BackupGGCode/hovercraft/README.md

#Hovercraft
Part of the Software for Embedded Systems course.  This sourcecode is used to create an autonomous hovercraft.
