BackupGGCode/hovercraft/projectWriteup/projectHTML/HovercraftDesign.html

# Design

The following figures show the top, side, front and rear views for the vehicle:

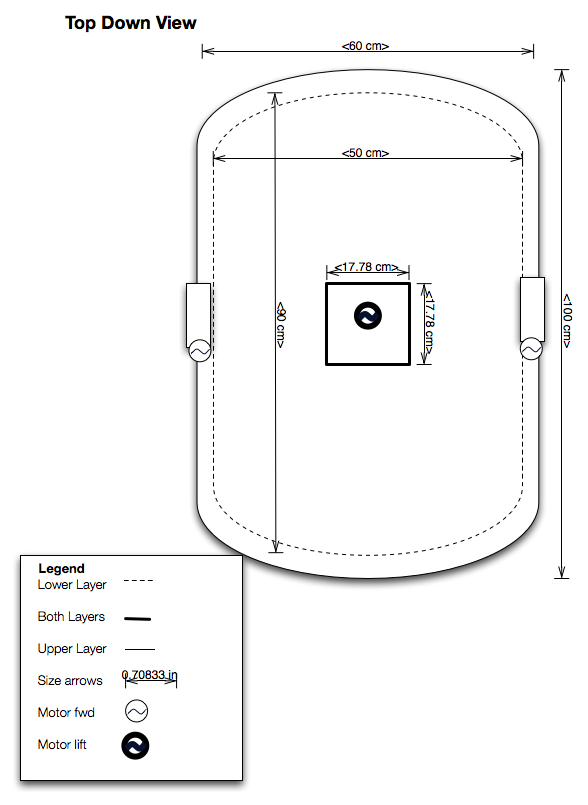
[picture p9: projectWriteup/ProjectGraphics/TopDown.png]


The first design consisted of a rounded front, straight sides and a straight back. However, since the front and back were not symmetric, we concluded that the rear of the craft should be rounded to match the front. This symmetric design better distributes the underlying air cushion to all parts of the vehicle.

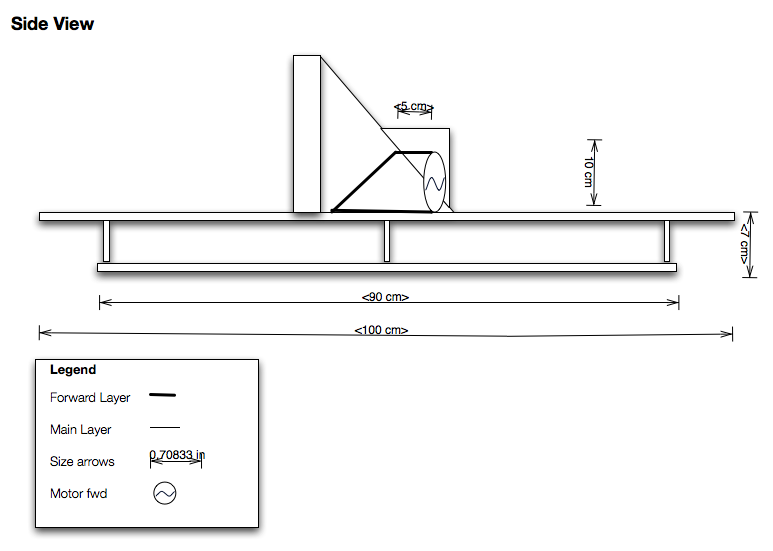
[picture p10: projectWriteup/ProjectGraphics/sideview.png]


The plenum chamber receives air from a single propeller mounted in the middle of the chasis. The middle propeller is housed by a triangular container. Initially the container was completely open on the side where the propeller draws air from. We realized that too much air was escaping from this hole and a cover with a circular cut-out was fitted over the opening. The cut-out better fit the diameter of the fan, resulting in minimal air escaping from the opening.



The electronic components are mounted at the rear of the hovercraft. This facilitates making connections from the breadboard to the nearby DC Motors, servo motor, and sonars. The combined mass of all the components added a significant force to the rear of the chasis. To counter this, we placed counter weights on the front of the body.



# Constraints

## Payload Weight

In order for the hovercraft to stay afloat, the internal air pressure must counter external forces placed on the surface of the vehicle by both gravity and the mass of the components. The following table describes the components and their masses:

Component | Quantity | Mass(grams)
Battery | 2 | 50
Breadboard | 1 | 45
Microcontroller | 1 | 15
Radio | 1 | 9
Sonar | 3 | 5
DC Motor (large) | 1 | 83
Servo Motor | 1 | 4
H-bridge | 1 | 6
DC Motor (small) | 2 | 25
Total | -- | 329

## Rigidity

The hovercraft body is made from two thin sheets of styrofoam separated by 12 styrofoam spacers 1'' thick. This has proven to be a very strong design, easily capable of supporting the payload of the electronics. In fact, we distributed additional weight evenly across the body and found that the hovercraft could support at least 1 kg.





An inflatable skirt made of mylar surrounds the body. Mylar is a polyester film often used in flexible packaging for food, as an insulating material, and for solar reflection. Once inflated, the skirt serves two purposes. First, because it expands to over two inches, it provides additional surface area, reducing the overall pressure at any given point on the body. Second, the skirt acts as a flexible and damage resistant bumper, protecting the body from nearby objects during testing. We used two different mediums to connect the skirt to the styrofoam body. First we adhered the mylar to the styrofoam using hot glue, we then went around the perimeter with a hot iron to melt the mylar, the glue and the styrofoam together.



After the styrofoam chasis was built, we then procdeded to construct the skirt. The first attempt at constructing the mylar skirt was not successful. Lack of foresight resulted in a skirt that was too baggy in some areas, while exposing too many holes in others. The first time that we attached the mylar, when we were connecting the corners, we used clear packing tape, and simply folded the corners together. The second attempt was much more calculated and pragmatic. When connecting the corners of the second skirt, we methodically folded the edges in, then removed the square that was not attached (see Mylar-Cutout diagram). After this we made the connection using the hot iron to glue the seam together. The resulting skirt was much more evenly distributed and provided reasonably uniform inflation around the entire body. That said, the hovercraft still managed to move about when it was supposed to be idle. We addressed this issue by placing weights on the body to counteract the uneven escape of air on one side.

## Lift

The decision to use a single, vertically mounted propeller to feed air into the plenum chamber was in direct response to the problem of rotational torque plaguing horizontally mounted propellers. In a horizontal design, the rotation of the blades applies an overall torque on the hovercraft causing it to spin. Dealing with this force is a burden. One approach is to install a second horizontal propeller which spins in the opposite direction. The opposite spin of the two motors cancels any directional torque felt by the craft. We chose to avoid this problem entirely by mounting a single motor vertically in the middle of the body. A container built over the propeller captures the incoming air and forces into the plenum chamber.





To avoid ground effect, we applied full power to the lift propeller. Next, we methodically added weight to the body such that the hovercraft moved freely along the ground, but was not vastly overpowered by the fan. Keeping the vehicle as close as possible to the ground allows for the most control over the hovercraft's direction.

## Thrust and Control

The following two figures show the first design we had chosen to provide the vehicle with thrust. The two differential motors were mounted at the rear, and were spaced fairly close together.





We decided to change this design. By placing the motors as far apart as possible, maximum torque could be achieved. The analogy is as follows. Consider the act of opening a door. It is much easier to open a door if you push on the edge furthest from the hinges, because you can generate much more torque. The same goes for our hovercraft. Ideally the centre of rotation (the hinge) is in the centre of the hovercraft. By placing the motors as far away from this centre, we will create the most rotational torque and the craft will be easily controlled

### Remote Control Code

The following functions are part of the base station software. They are used to send control signals form the joystick to the hovercraft, using radio communication.

	unsigned char X = 0, Y = 0, Z = 0;

	void updateMotor(){	
		packet_t packet;

		sample_joystick(&X,&Y,&Z);

		_delay_ms(250);
		char test[50];	
		updateVertically();

		packet.x = (uint8_t) X;
		packet.y = (uint8_t) Y;
		radio_send(HOV_ADDRESS, (uint8_t*) &packet);	
	}

	void updateVertically(){
		int intY = (int) Y;
		int len = 0;
		char toWrite[50];
		uint8_t newSpeed = 0;

		if(intY > 125){ //To go Backwards
			setMotorDirection(BACKWARD);
			newSpeed = (intY-125)*2;
			setMotorSpeed( newSpeed);
			len = sprintf(toWrite, "Motor Speed Is Backward %d\r\n", intY);
		}else{
			setMotorDirection(FORWARD);
			newSpeed = 256 - intY*2;
			setMotorSpeed(newSpeed);
			len = sprintf(toWrite, "Motor Speed Is Forward %d\r\n", newSpeed);
		}

		_delay_ms(250);	
	}

### Differential Turning Code

To implement differential turning, we began by using the provided motor driver code. We then defined a struct to abstract a motor:

	/**
	 * A motor type.
	 */
	typedef struct
	{
	    /** The port at which the PWM signal is coming out of. */
	    volatile uint8_t *pwmPort;

	    /** The data direction register for PWM. */
	    volatile uint8_t *pwmDDR;

	    /** The PWM pin. */
	    uint8_t pwmPin;

	    /** The port at which the direction of the motor can be controlled. */
	    volatile uint8_t *directionPort;

	    /** The data direction register for the direction pin. */
	    volatile uint8_t *directionDDR;

	    /** The direction pin. */
	    uint8_t directionPin;

	    /** The register that contains the TOP value. */
	    volatile uint8_t *topRegister;
	} motor_t;

We also defined an enumerated type to represent forward and backward direction:

	typedef enum
	{
	    FORWARD, BACKWARD
	} direction_t;

The two motors and the timer for pulse width modulation must first be initialized:

	/**
	 * Initialization method for the motors.
	 *
	 * @param motor The motor to be initialized.
	 */
	void motorInit(motor_t * motor);

	/**
	 * Initializes the Timer/Counter 0 for PWM.
	 */
	void pwmInit();

The following functions are used to control the independent speed and direction of the motors. By allowing the duty of each motor to be set, differential turning can be established.

/**
 * Sets the speed of the motor.
 *
 * @param motor The motor to be affected.
 * @param duty  The new duty cycle.
 */
void setMotorDuty(motor_t *motor, int duty);

/**
 * Sets the motor direction.
 *
 * @param motor     The motor to be affected.
 * @param direction The direction for the motor to spin.
 */
void setMotorDirection(motor_t *motor, direction_t direction);
