BackupGGCode/hovercraft/projectWriteup/ProjectGraphics/DifferentialTurning.graffle/QuickLook/Preview.pdf

# Differential Turning

Differential turning is achieved by placing two propellers at the rear of the hovercraft. By applying different duties to each of the propellers (via PWM), one will spin faster than the other, causing the vehicle to turn.
