BackupGGCode/hovercraft/projectWriteup/ProjectGraphics/VortexRing.graffle/QuickLook/Preview.pdf

# Vortex Ring

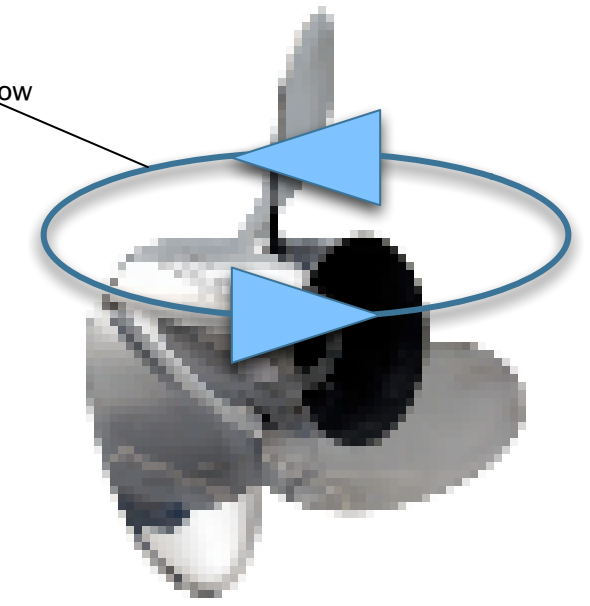
[picture p12: figure]

Airflow begins to loop back through the propeller, severely reducing lift.

Airflow
