BackupGGCode/hovercraft/projectWriteup/FINAL_REPORT/main.tex

%\documentclass[letterpaper]{sig-alternate}
\documentclass{article}
\usepackage[left=1.0in,right=1.0in,nohead,nofoot]{geometry}
\usepackage{multirow} 
\usepackage{rotating}
\usepackage{listings}
\usepackage{color}
\usepackage{capt-of}
\usepackage{caption}
\usepackage{float}
\usepackage{subfig}
\usepackage{pdfsync}
\usepackage[bookmarks=true,pdftex]{hyperref}

\begin{document}
\lstset{captionpos=b,
        breaklines=true,
        frame=single,
        showstringspaces=false,
        basicstyle=\footnotesize,
        numberstyle=\tiny,
        tabsize=2,
        language=C,
        numbers=left,
        stepnumber=2,
        numbersep=5pt,
        commentstyle=\textit}

%\conferenceinfo{}
%\CopyrightYear{}
%\crdata{}

\title{Software for Embedded Systems\\Hovercraft Project\\Final Report}

\author{Darren Minifie \and Marco Yuen \and Kat Gunion \and Anthony Estey}

\date{April 23, 2009}
\maketitle
\begin{abstract}
Hovercraft report abstract here.
\end{abstract}

\tableofcontents
\listoffigures
\listoftables
\newpage

%A category including the fourth, optional field follows...
%\category{D.2.8}{Software Engineering}{Metrics}[complexity measures, performance measures]

%\terms{}

\section{Introduction}
\input{textSources/introduction}
\clearpage
\section{Electronic Components and Their Interface}
\input{textSources/electronicComponents}
\clearpage
\section{Hovercraft Design and Construction}
\input{textSources/hovercraftDesignConstruction}
\clearpage
\section{PID Controller}
\input{textSources/pidController}
\clearpage
\section{Embedded Software for Automation}
\label{embeddedSoftwareAutomation}
\input{textSources/embeddedSoftwareAutomation}
\clearpage
\section{Real Time Operating System (RTOS)}
\input{textSources/rtos}
\clearpage
\section{Physical Parameters: Methodologies and Measurements}
\input{textSources/methodsMeasurements}
\clearpage
%\section{Observations and Evaluations}
%\input{textSources/observationsEvaluations}
%\clearpage
\section{Conclusion}
\input{textSources/conclusion}
\clearpage
%ACKNOWLEDGMENTS are optional
%\section{Acknowledgments}

\bibliographystyle{abbrv}
\bibliography{bibliography}  % sigproc.bib is the name of the Bibliography in this case

\end{document}
