BackupGGCode/hovercraft/projectWriteup/FINAL_REPORT/imageSources/Bottom2.png

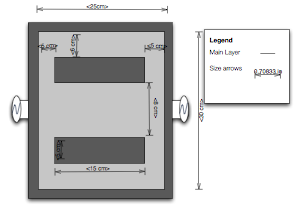
projectWriteup/FINAL_REPORT/imageSources/Bottom2.png
