BackupGGCode/hovercraft/projectWriteup/FINAL_REPORT/imageSources/BottomFinal.png

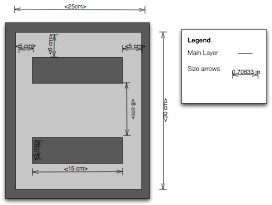
projectWriteup/FINAL_REPORT/imageSources/BottomFinal.png
