BackupGGCode/hovercraft/projectWriteup/FINAL_REPORT/imageSources/SideViewFinal.png

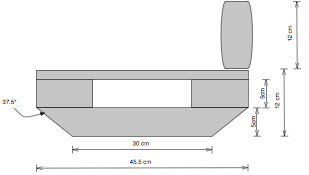
projectWriteup/FINAL_REPORT/imageSources/SideViewFinal.png
