BackupGGCode/hovercraft/projectWriteup/hover_pics/fans_back.jpg

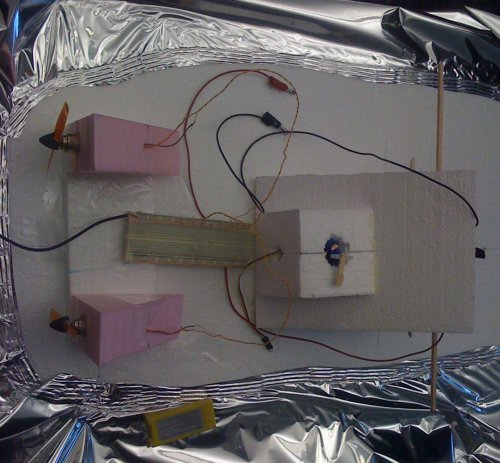
projectWriteup/hover_pics/fans_back.jpg
