BackupGGCode/hovercraft/projectWriteup/hover_pics/fans_mid.jpg

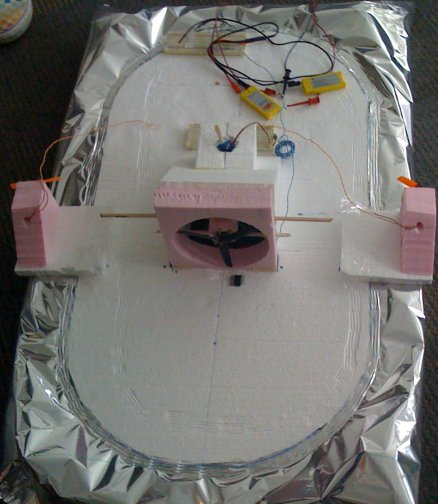
projectWriteup/hover_pics/fans_mid.jpg
