BackupGGCode/hovercraft/projectWriteup/hover_pics/HBridge_heatsink.jpg

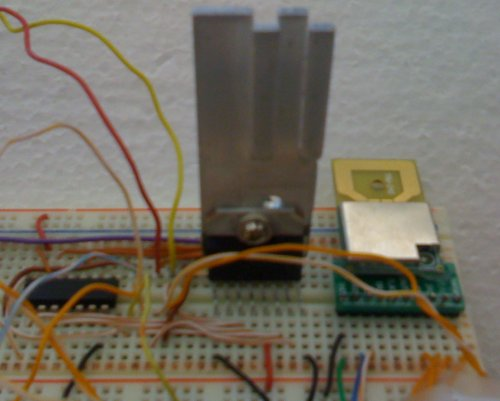
projectWriteup/hover_pics/HBridge_heatsink.jpg
