BackupGGCode/hovercraft/projectWriteup/hover_pics/Hbridge_parallel.jpg

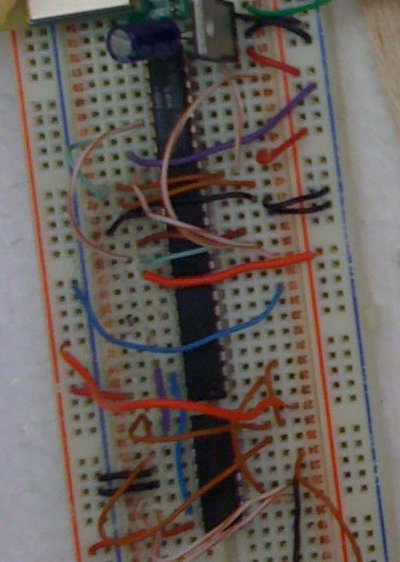
projectWriteup/hover_pics/Hbridge_parallel.jpg
