BackupGGCode/hovercraft/projectWriteup/hover_pics/IMG_0016.jpg

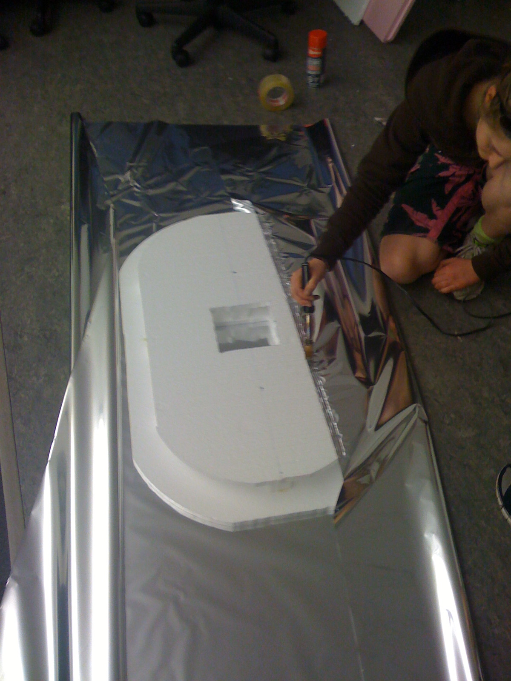
projectWriteup/hover_pics/IMG_0016.jpg
