BackupGGCode/hovercraft/projectWriteup/hover_pics/IMG_0017.JPG

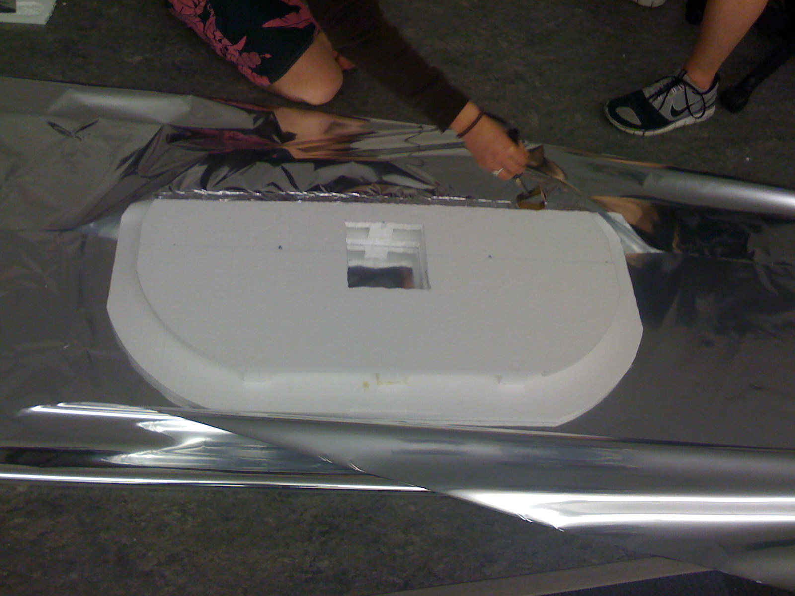
projectWriteup/hover_pics/IMG_0017.JPG
