BackupGGCode/hovercraft/projectWriteup/hover_pics/IMG_0018.JPG

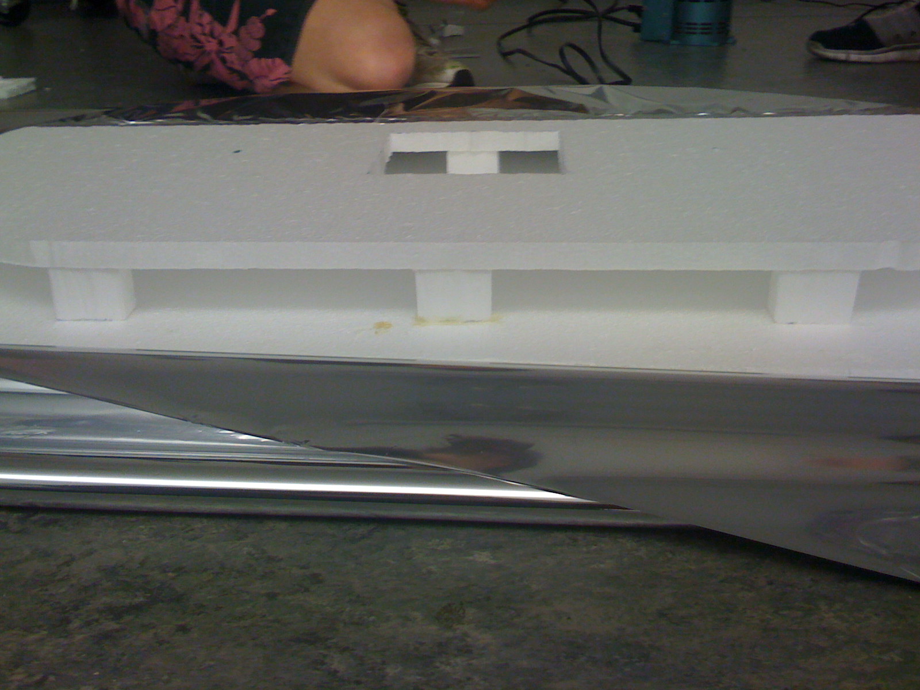
projectWriteup/hover_pics/IMG_0018.JPG
