BackupGGCode/hovercraft/projectWriteup/hover_pics/IMG_0019.JPG

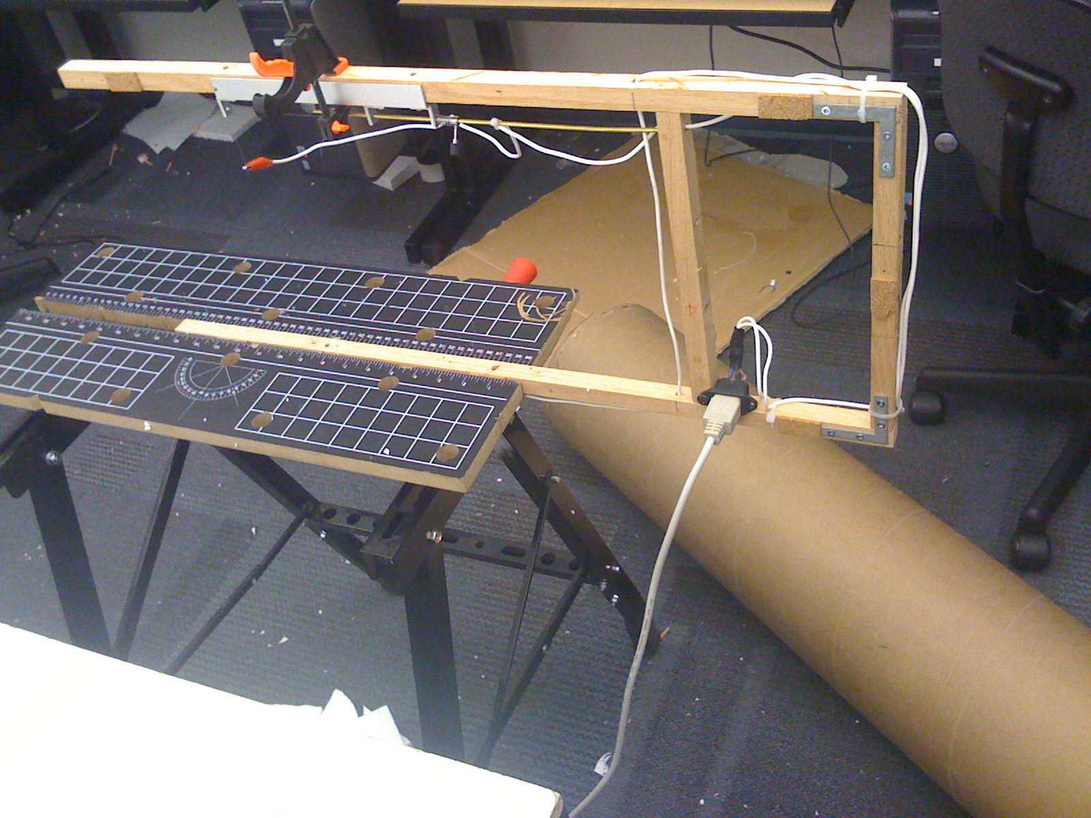
projectWriteup/hover_pics/IMG_0019.JPG
