BackupGGCode/hovercraft/projectWriteup/hover_pics/IMG_0020.JPG

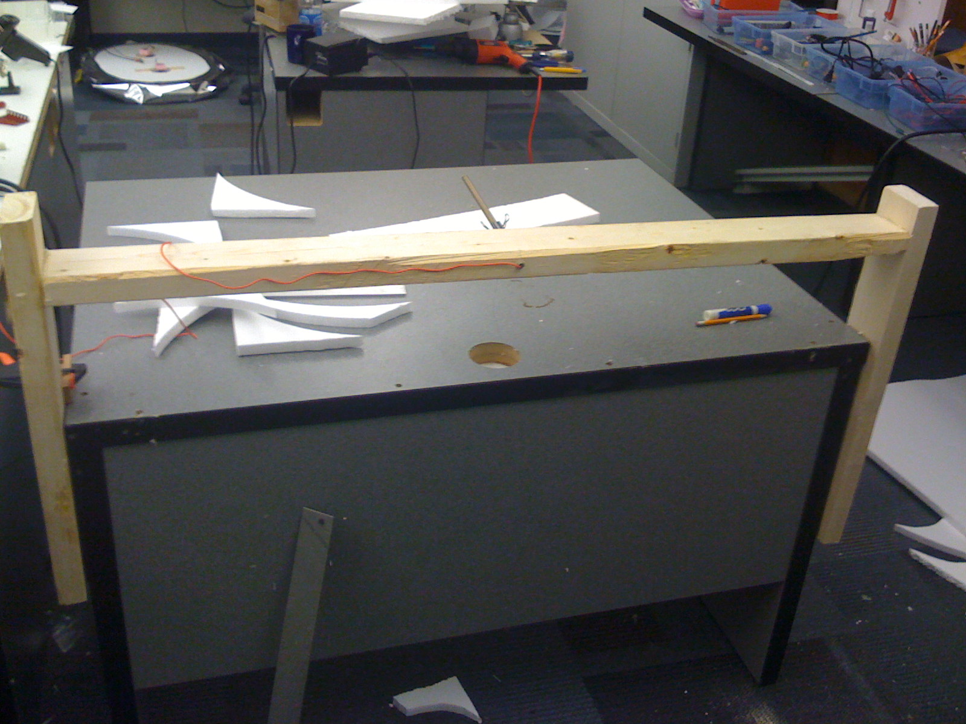
projectWriteup/hover_pics/IMG_0020.JPG
