BackupGGCode/hovercraft/projectWriteup/hover_pics/IMG_0021.jpg

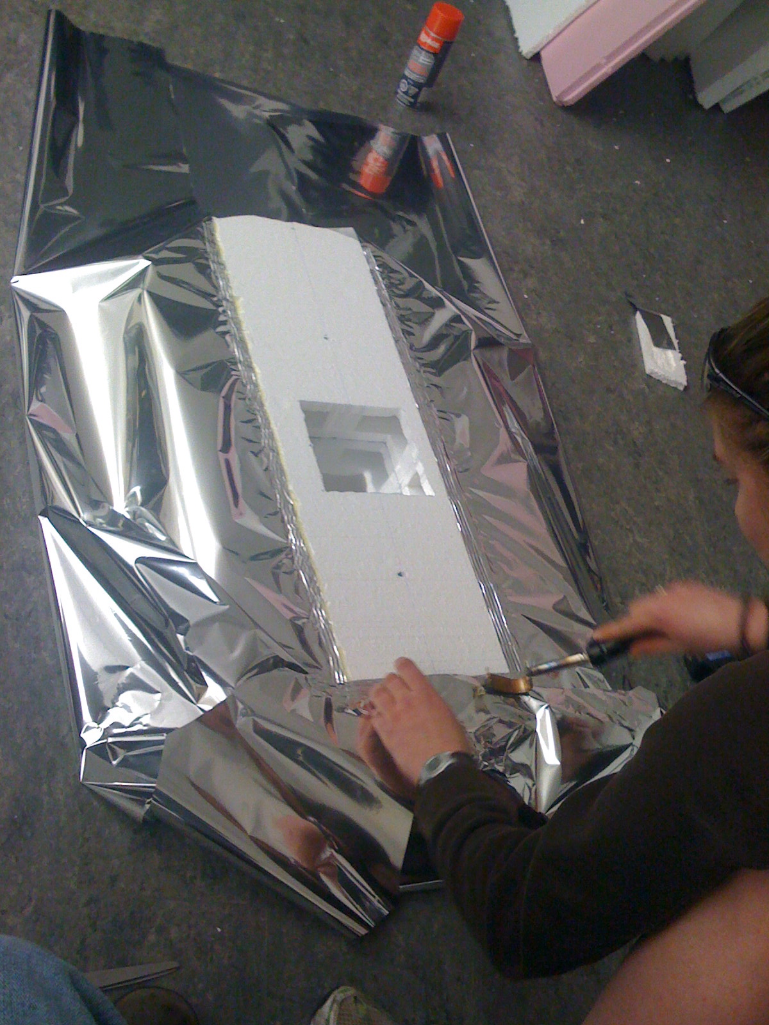
projectWriteup/hover_pics/IMG_0021.jpg
