BackupGGCode/hovercraft/projectWriteup/hover_pics/IMG_0022.JPG

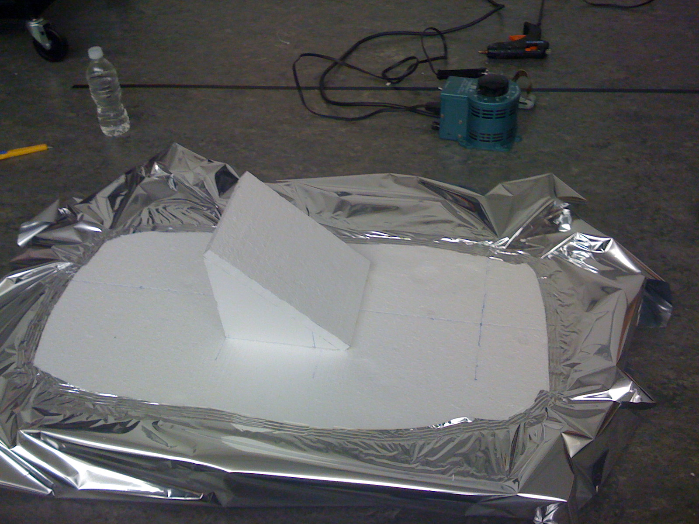
projectWriteup/hover_pics/IMG_0022.JPG
