BackupGGCode/hovercraft/projectWriteup/hover_pics/IMG_0023.jpg

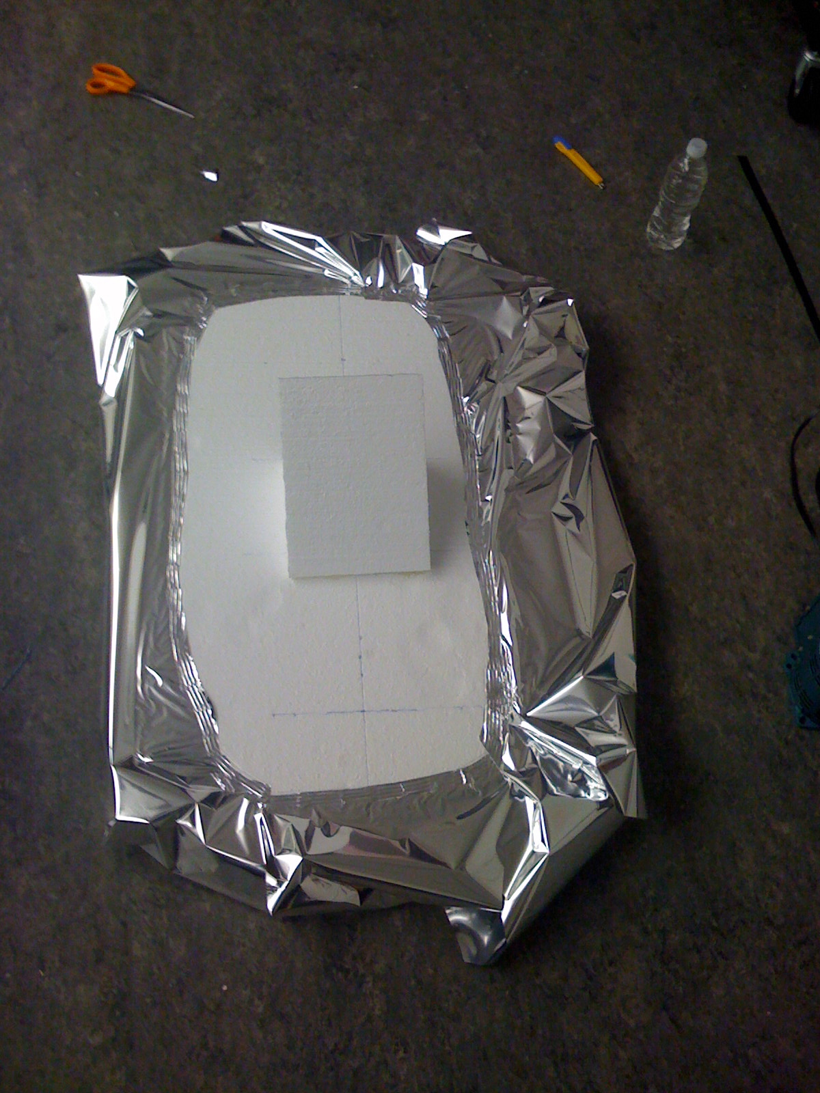
projectWriteup/hover_pics/IMG_0023.jpg
