BackupGGCode/hovercraft/projectWriteup/hover_pics/IMG_0024.jpg

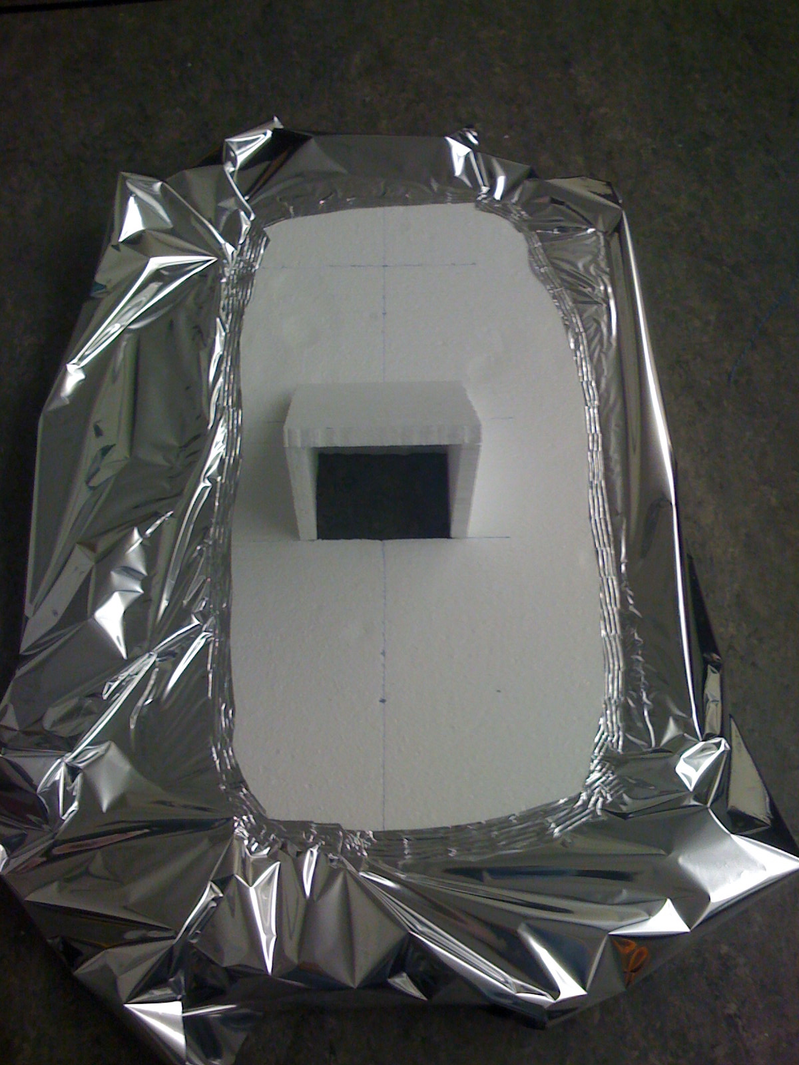
projectWriteup/hover_pics/IMG_0024.jpg
