BackupGGCode/hovercraft/projectWriteup/hover_pics/IMG_0025.jpg

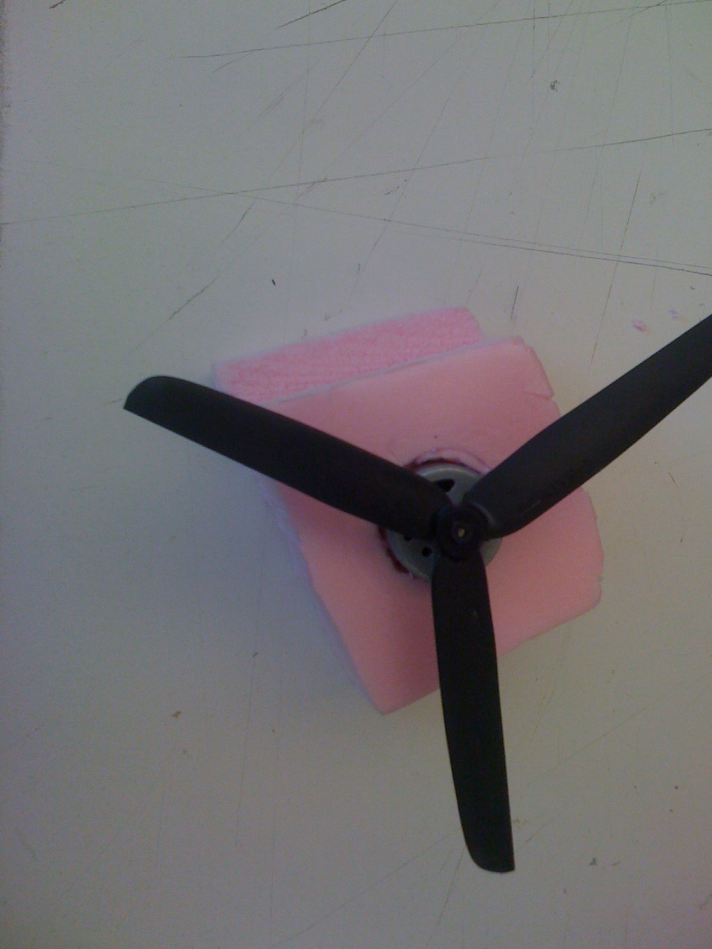
projectWriteup/hover_pics/IMG_0025.jpg
