BackupGGCode/hovercraft/projectWriteup/hover_pics/IMG_0026.JPG

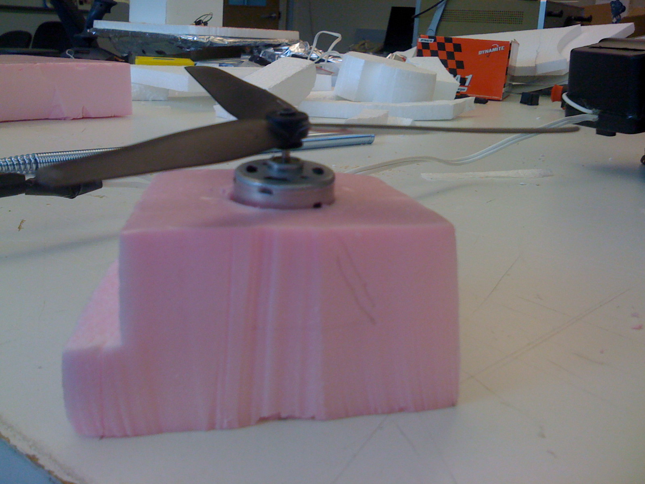
projectWriteup/hover_pics/IMG_0026.JPG
