BackupGGCode/hovercraft/projectWriteup/hover_pics/IMG_0027.JPG

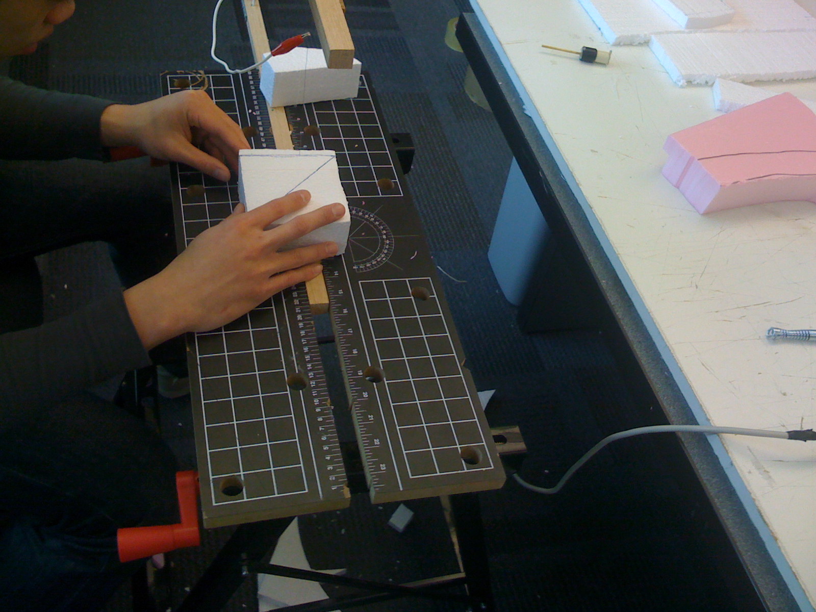
projectWriteup/hover_pics/IMG_0027.JPG
