BackupGGCode/hovercraft/projectWriteup/hover_pics/IMG_0028.JPG

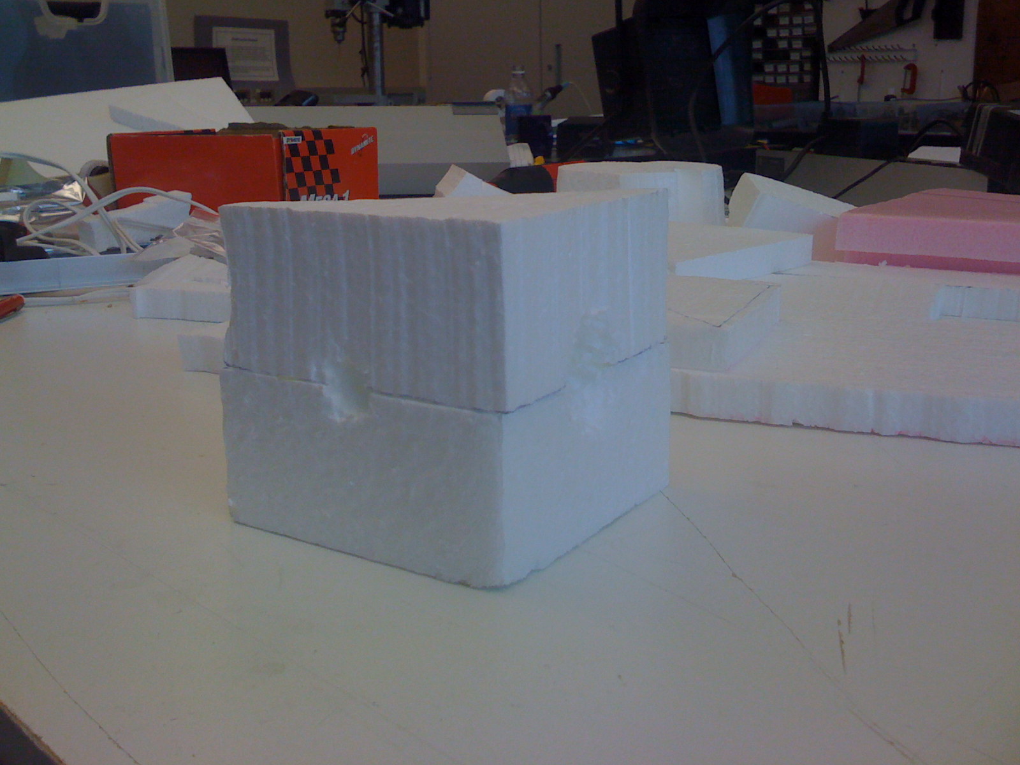
projectWriteup/hover_pics/IMG_0028.JPG
