BackupGGCode/hovercraft/projectWriteup/hover_pics/IMG_0029.jpg

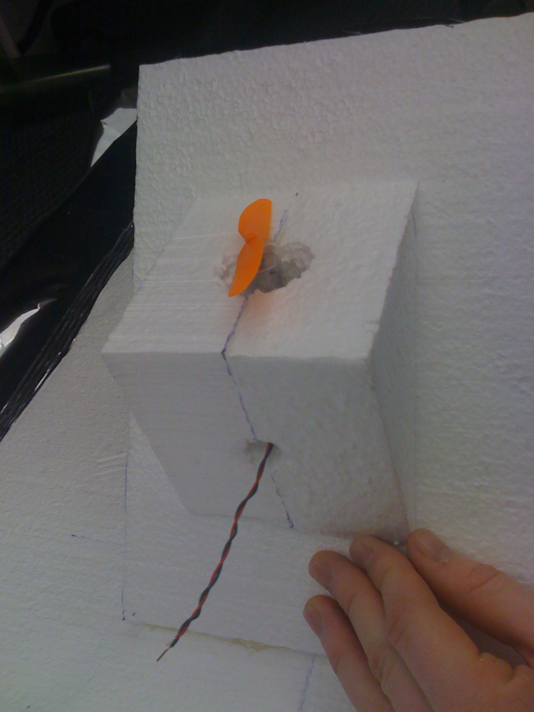
projectWriteup/hover_pics/IMG_0029.jpg
