BackupGGCode/hovercraft/projectWriteup/hover_pics/IMG_0030.JPG

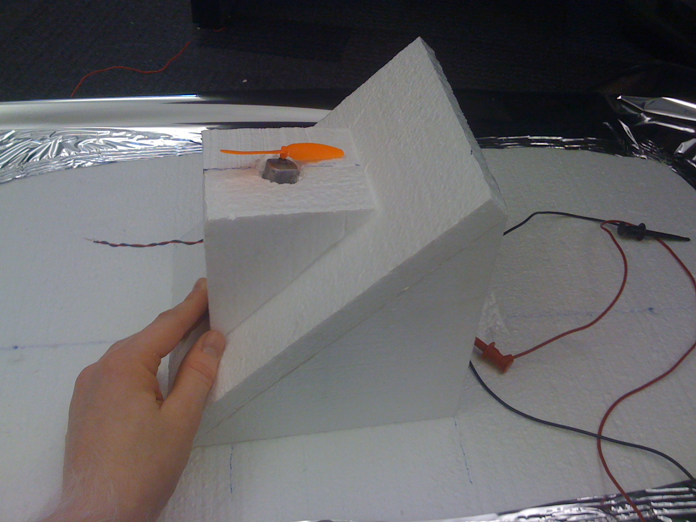
projectWriteup/hover_pics/IMG_0030.JPG
