BackupGGCode/hovercraft/projectWriteup/hover_pics/IMG_0031.jpg

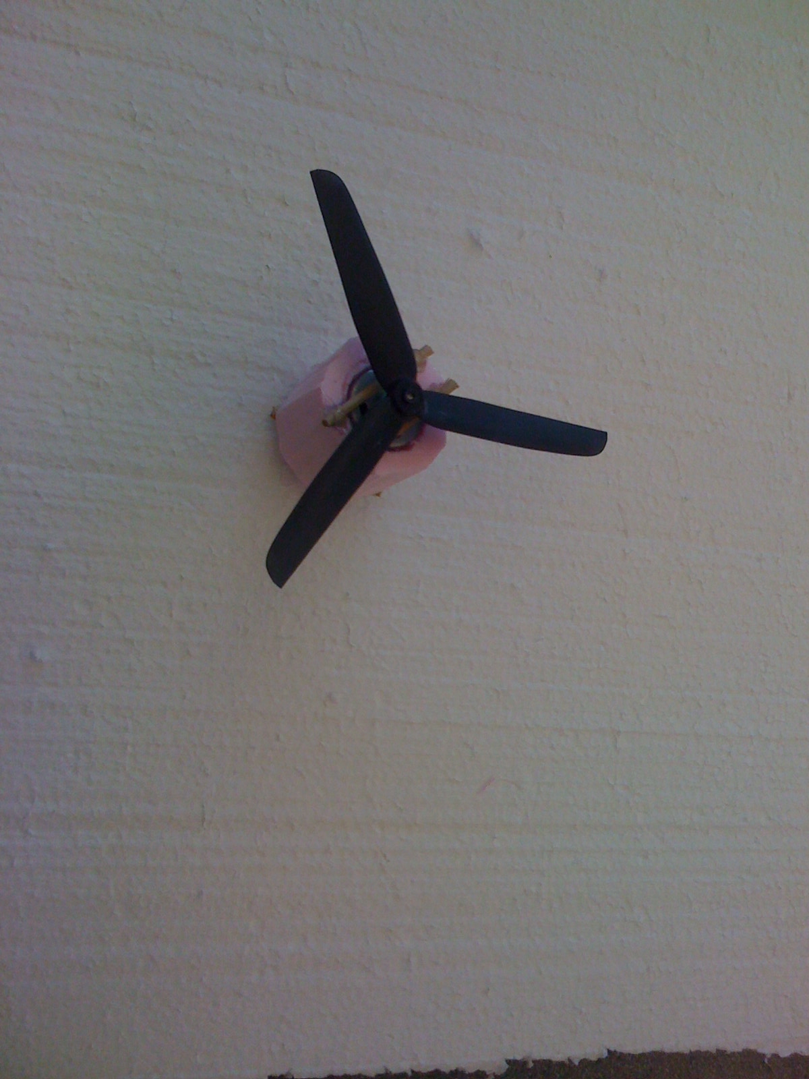
projectWriteup/hover_pics/IMG_0031.jpg
