BackupGGCode/hovercraft/projectWriteup/hover_pics/IMG_0032.JPG

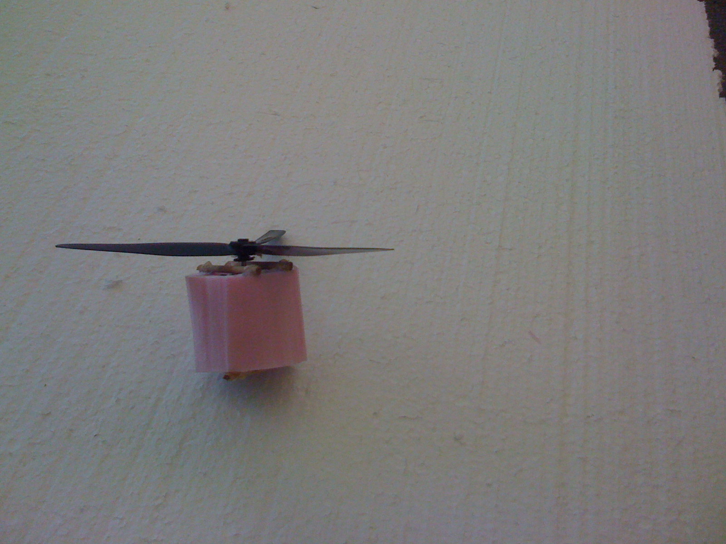
projectWriteup/hover_pics/IMG_0032.JPG
