BackupGGCode/hovercraft/projectWriteup/hover_pics/IMG_0033.jpg

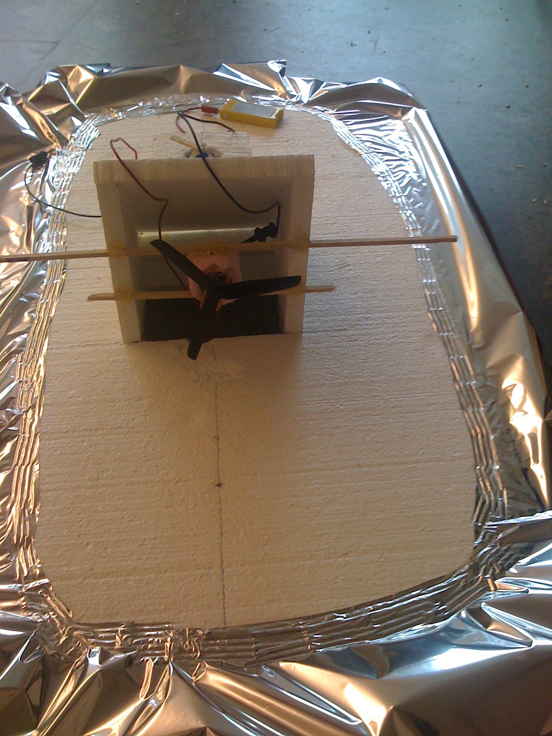
projectWriteup/hover_pics/IMG_0033.jpg
