BackupGGCode/hovercraft/projectWriteup/hover_pics/IMG_0034.jpg

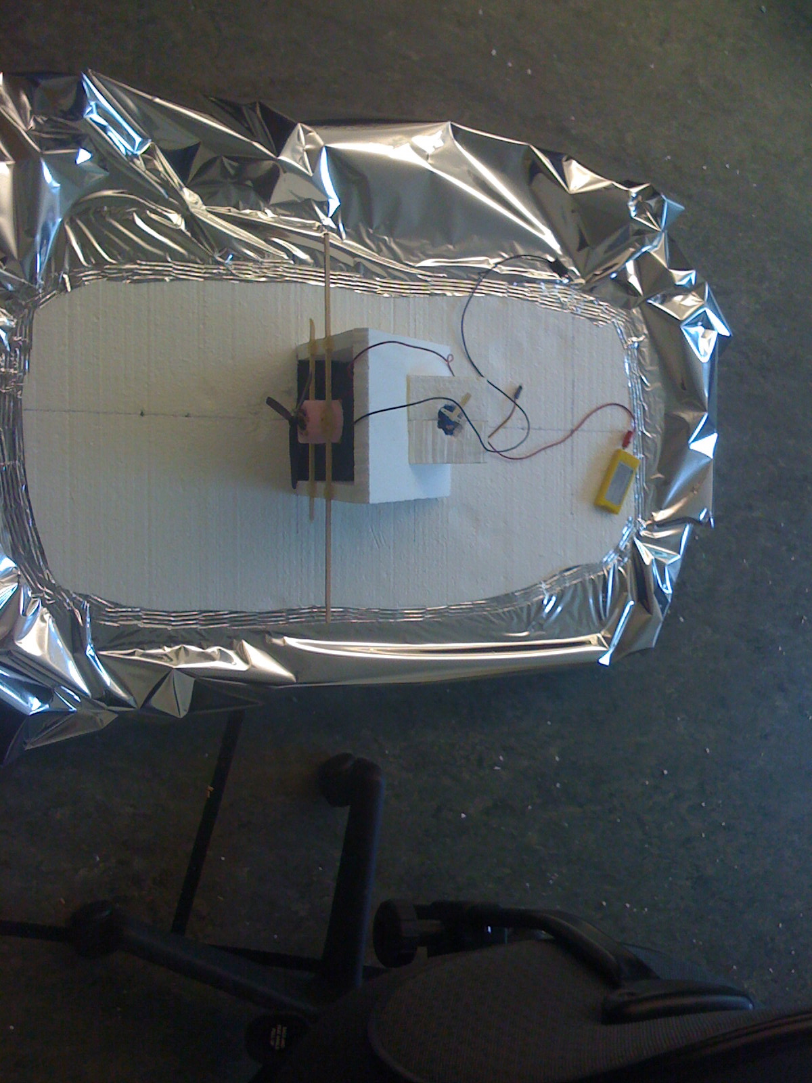
projectWriteup/hover_pics/IMG_0034.jpg
