BackupGGCode/hovercraft/projectWriteup/hover_pics/IMG_0035.JPG

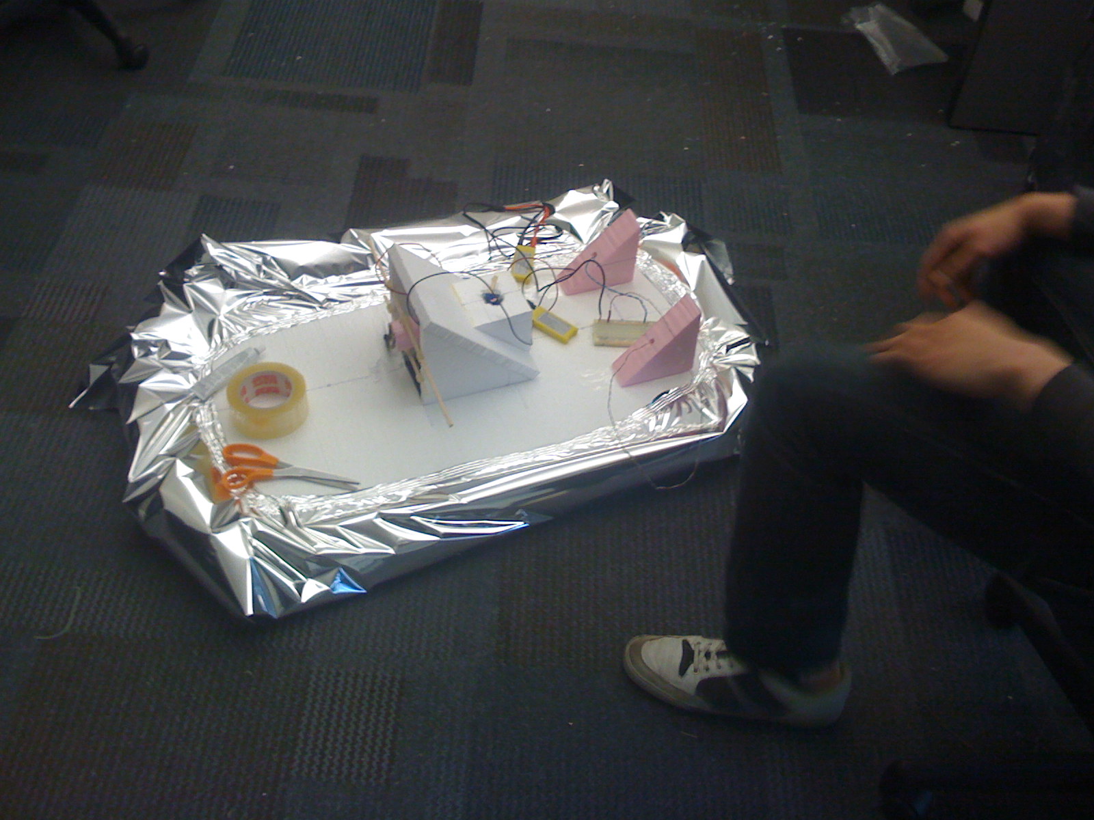
projectWriteup/hover_pics/IMG_0035.JPG
