BackupGGCode/hovercraft/projectWriteup/hover_pics/IMG_0036.jpg

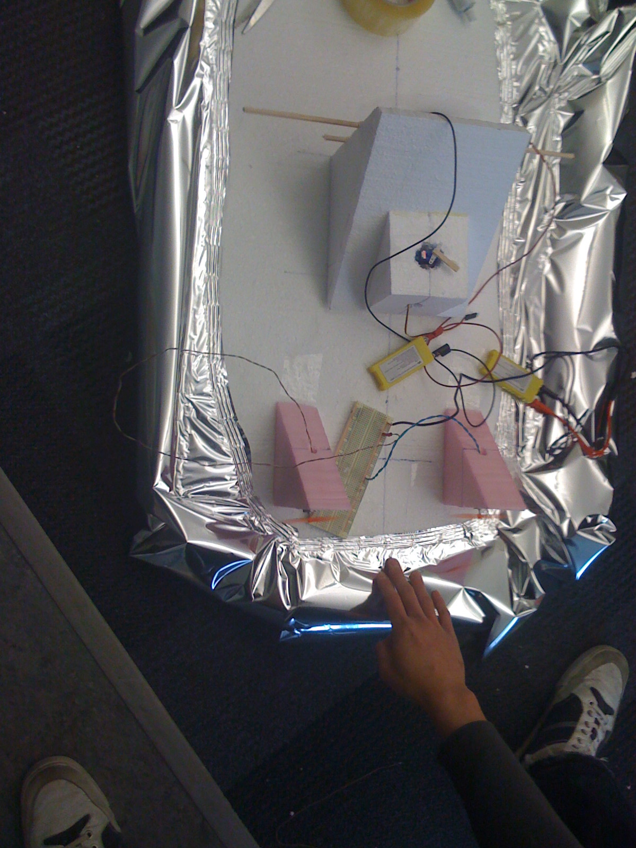
projectWriteup/hover_pics/IMG_0036.jpg
