BackupGGCode/hovercraft/projectWriteup/hover_pics/IMG_0037.JPG

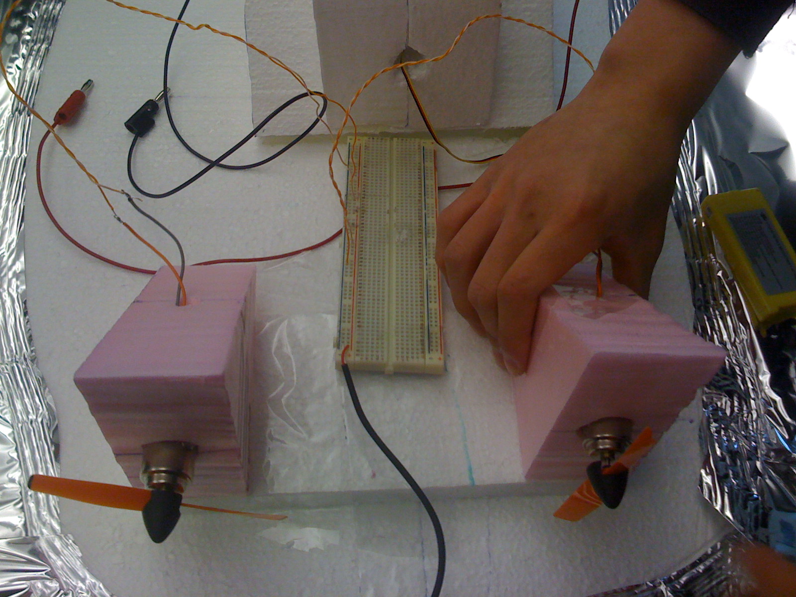
projectWriteup/hover_pics/IMG_0037.JPG
