BackupGGCode/hovercraft/projectWriteup/hover_pics/IMG_0038.jpg

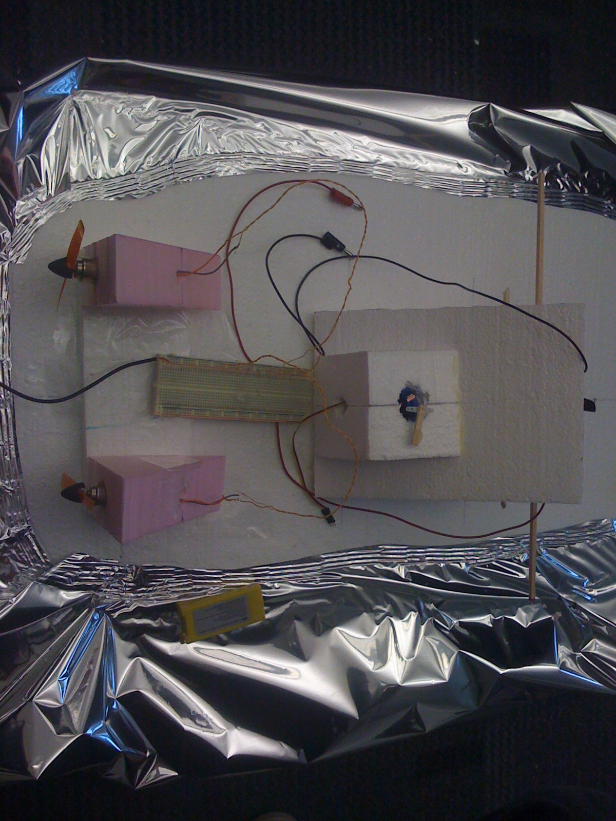
projectWriteup/hover_pics/IMG_0038.jpg
