BackupGGCode/hovercraft/projectWriteup/hover_pics/IMG_0039.jpg

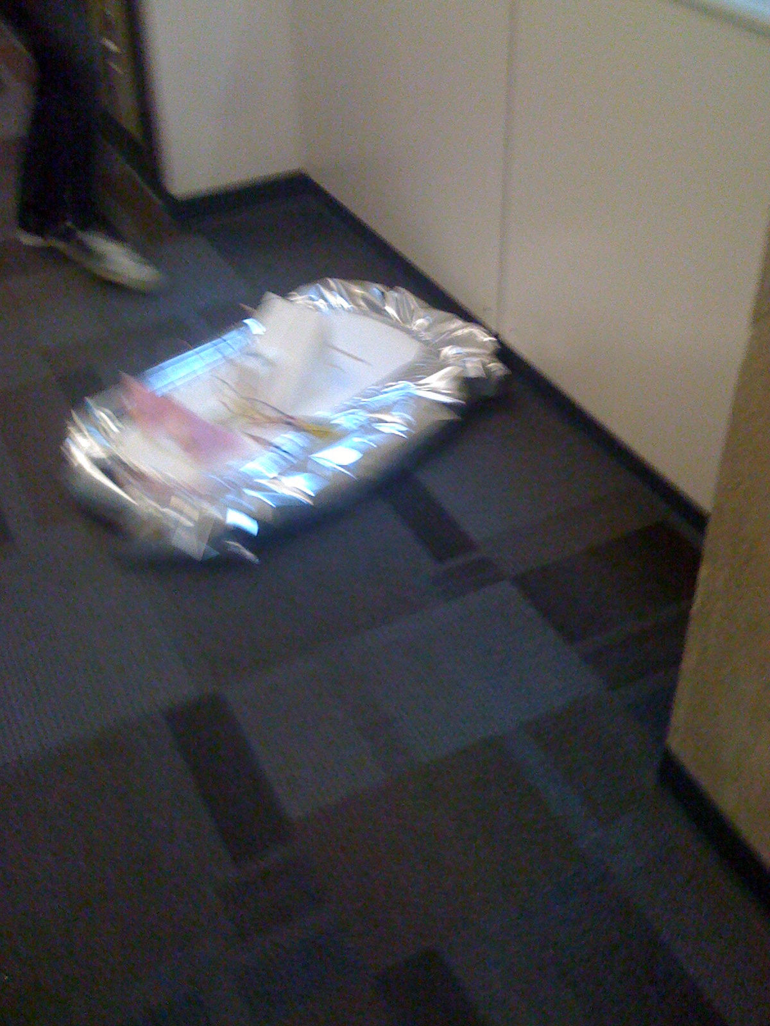
projectWriteup/hover_pics/IMG_0039.jpg
