BackupGGCode/hovercraft/projectWriteup/hover_pics/IMG_0040.jpg

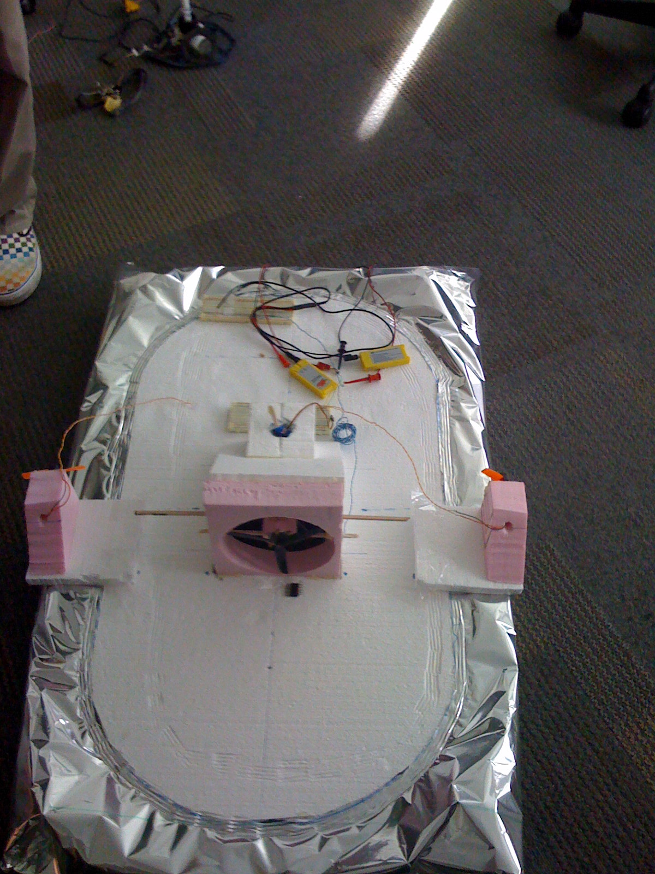
projectWriteup/hover_pics/IMG_0040.jpg
