BackupGGCode/hovercraft/projectWriteup/hover_pics/IMG_0041.jpg

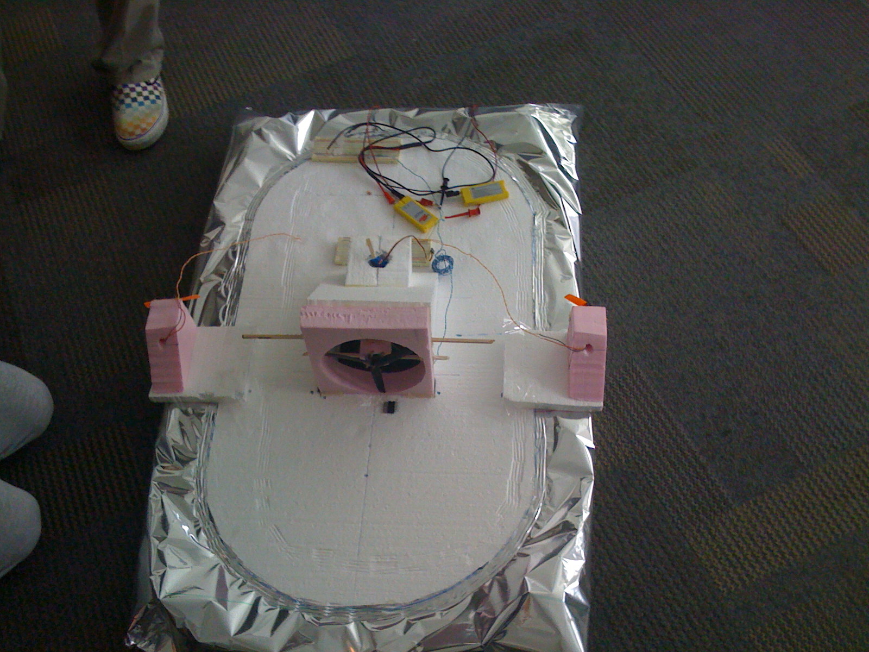
projectWriteup/hover_pics/IMG_0041.jpg
