BackupGGCode/hovercraft/projectWriteup/hover_pics/IMG_0042.jpg

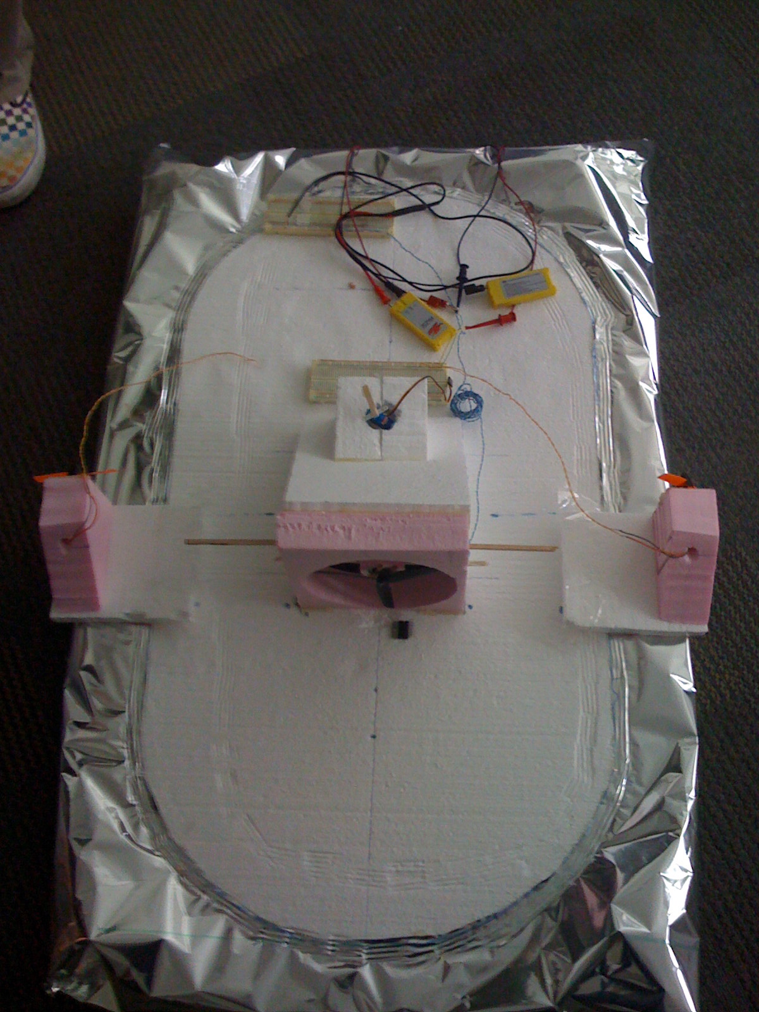
projectWriteup/hover_pics/IMG_0042.jpg
