BackupGGCode/hovercraft/projectWriteup/hover_pics/IMG_0043.jpg

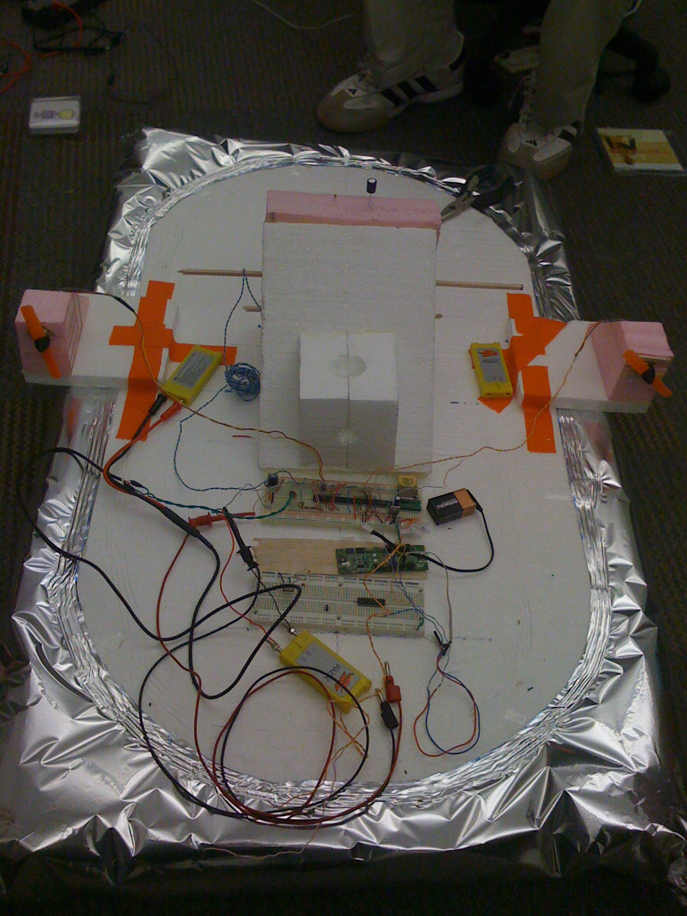
projectWriteup/hover_pics/IMG_0043.jpg
