BackupGGCode/hovercraft/projectWriteup/hover_pics/IMG_0044.jpg

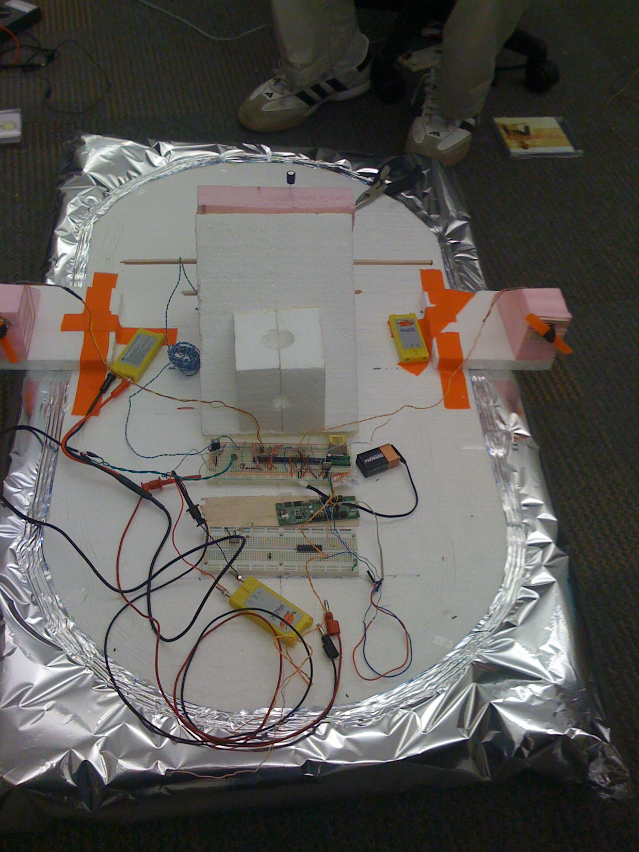
projectWriteup/hover_pics/IMG_0044.jpg
