BackupGGCode/hovercraft/projectWriteup/hover_pics/IMG_0045.jpg

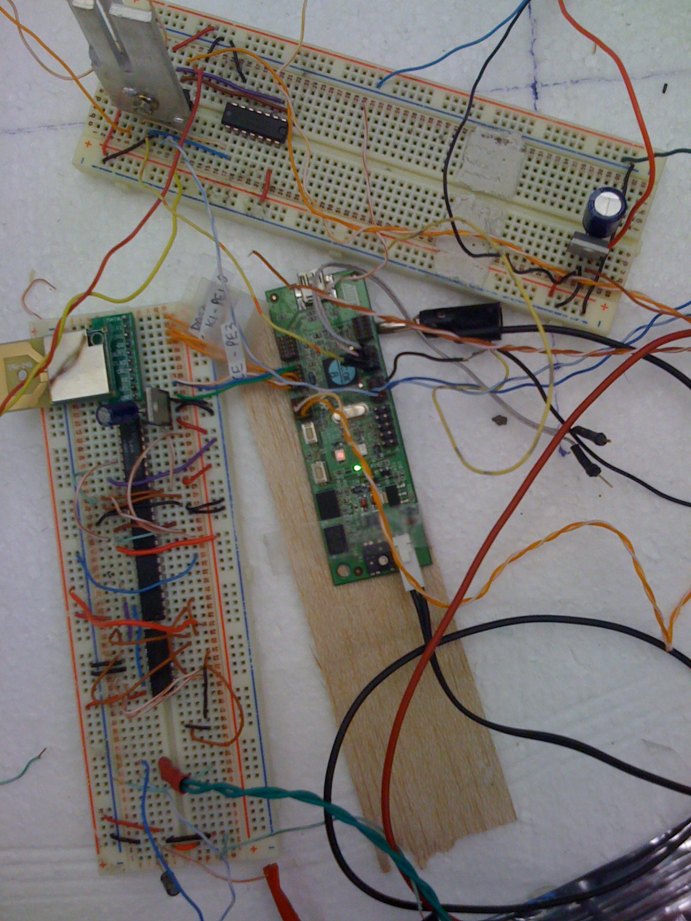
projectWriteup/hover_pics/IMG_0045.jpg
