BackupGGCode/hovercraft/projectWriteup/hover_pics/IMG_0046.jpg

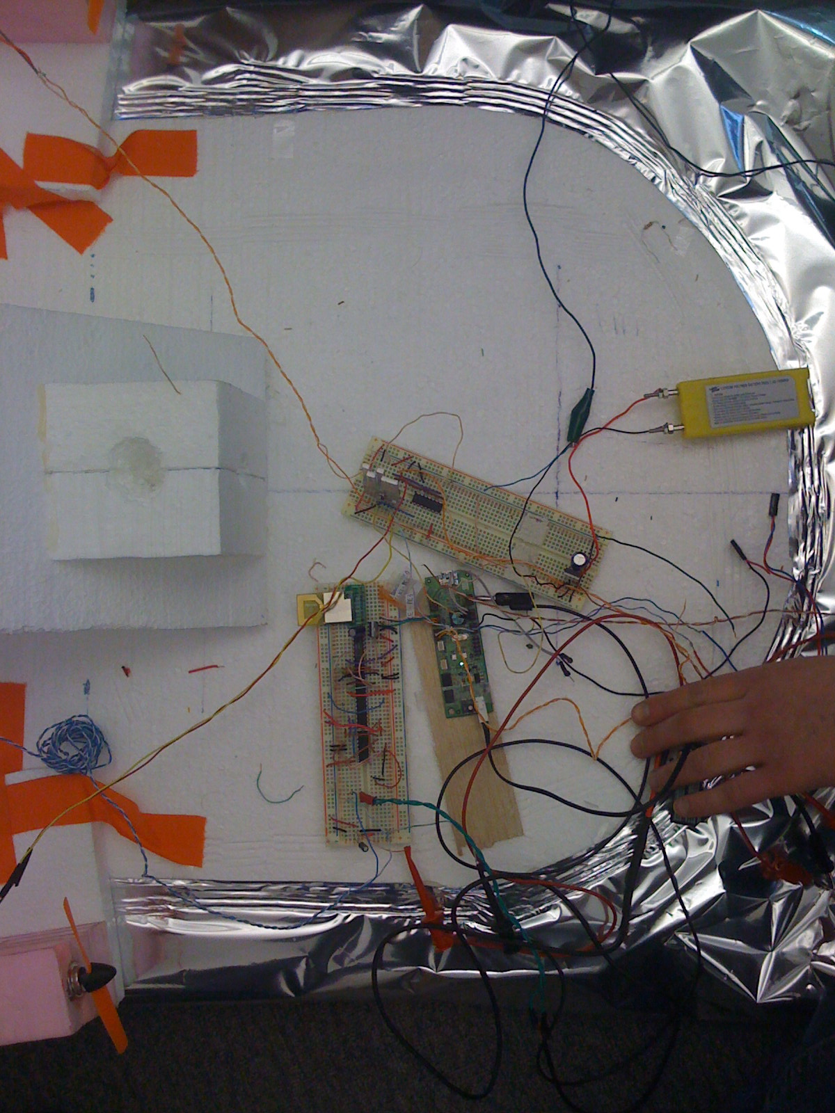
projectWriteup/hover_pics/IMG_0046.jpg
