BackupGGCode/hovercraft/projectWriteup/hover_pics/IMG_0047.JPG

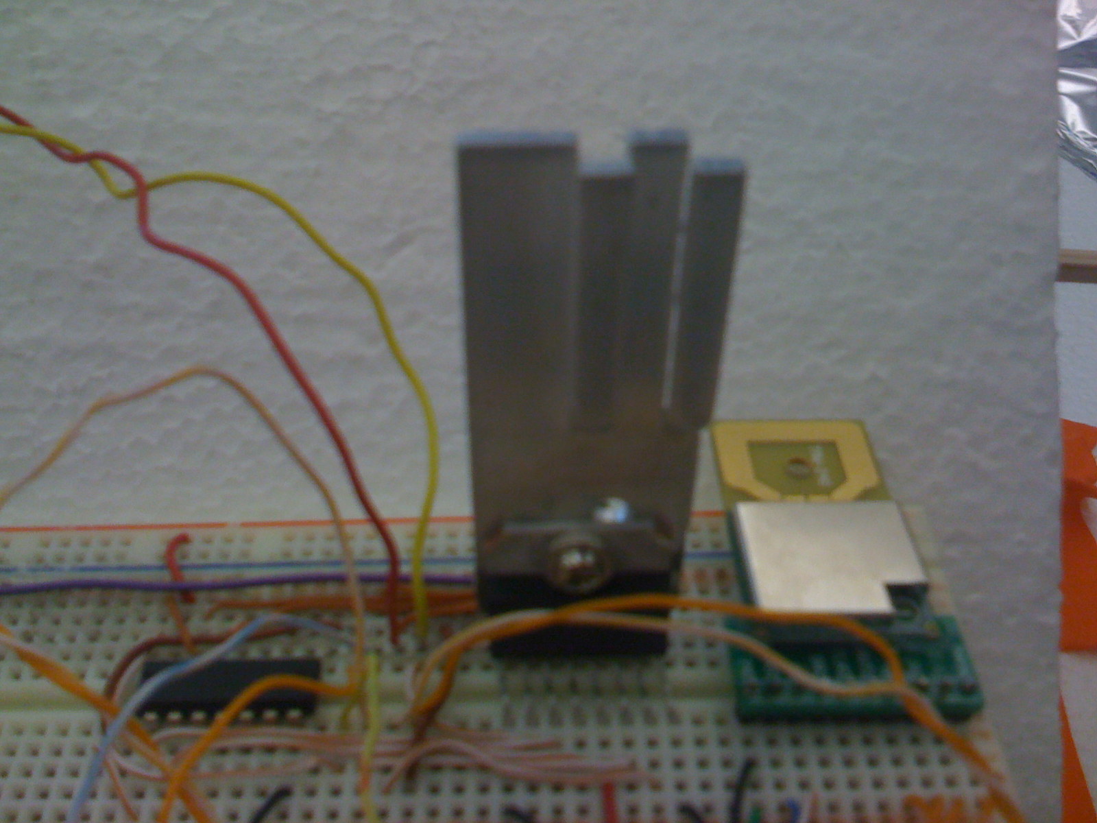
projectWriteup/hover_pics/IMG_0047.JPG
