BackupGGCode/hovercraft/projectWriteup/hover_pics/IMG_0048.JPG

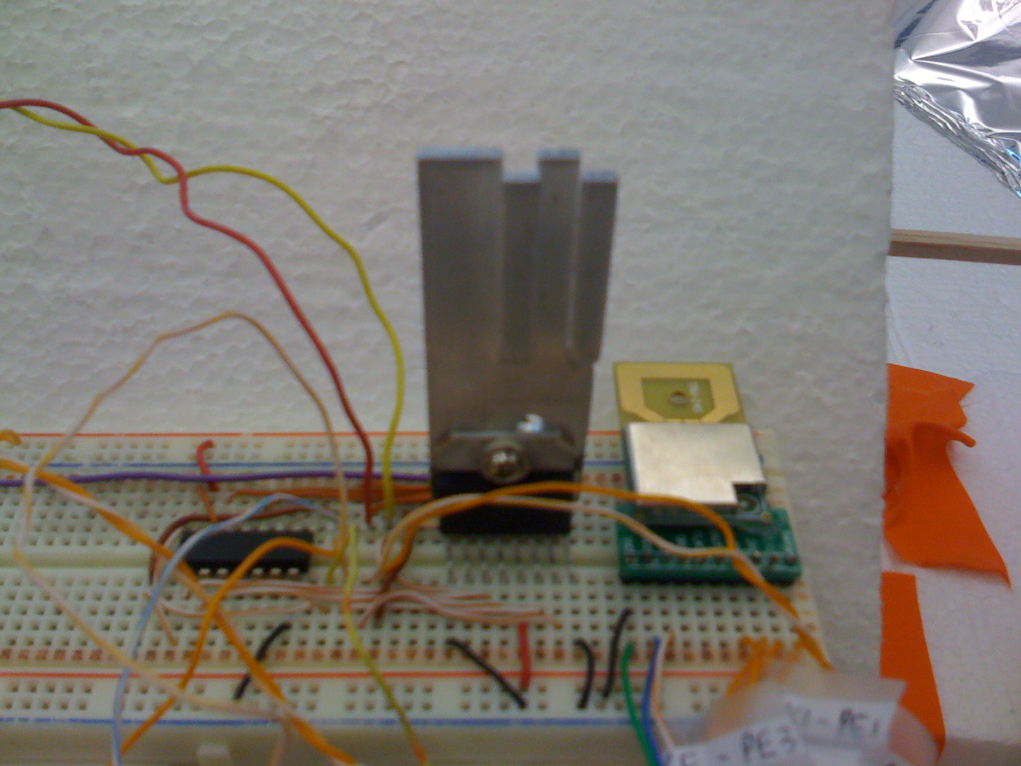
projectWriteup/hover_pics/IMG_0048.JPG
