BackupGGCode/hovercraft/projectWriteup/hover_pics/IMG_0049.JPG

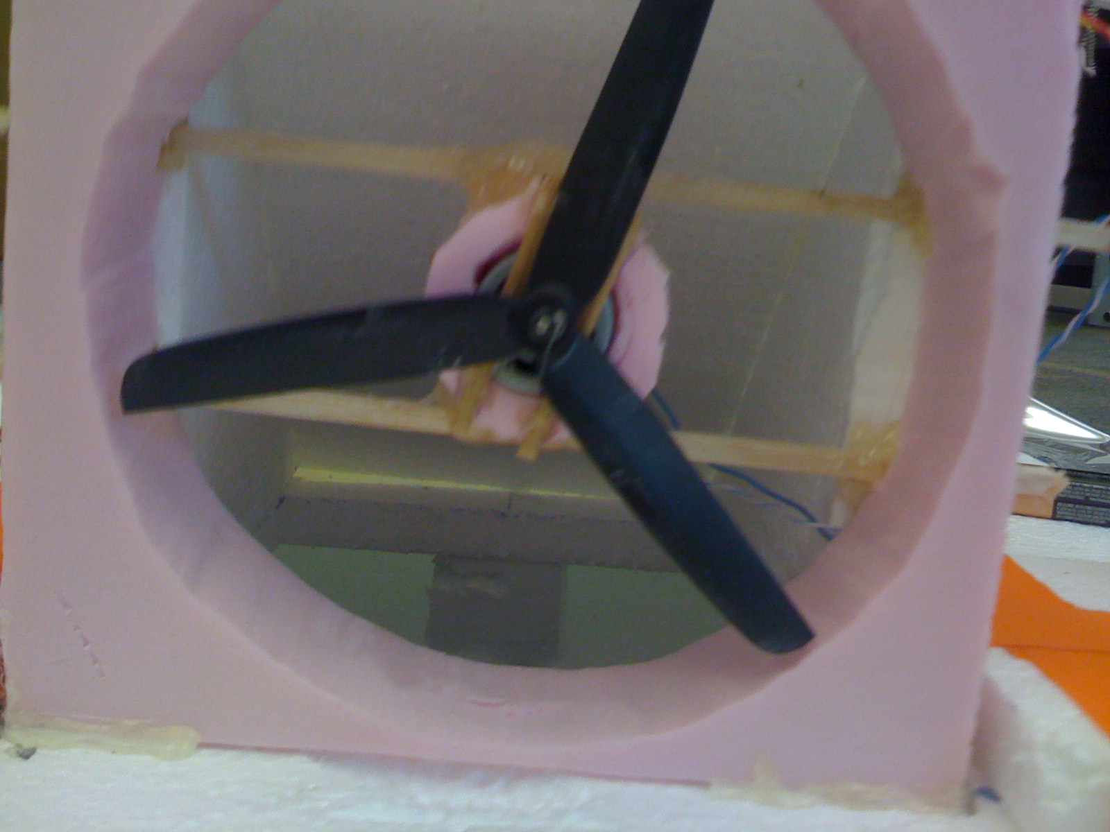
projectWriteup/hover_pics/IMG_0049.JPG
