BackupGGCode/hovercraft/projectWriteup/hover_pics/IMG_0050.JPG

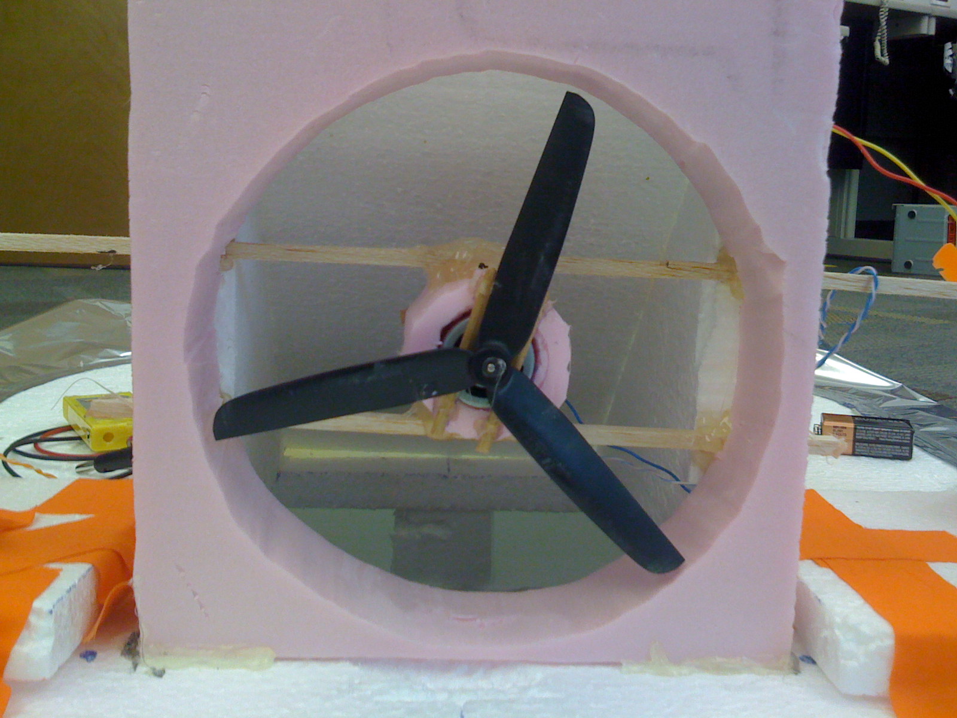
projectWriteup/hover_pics/IMG_0050.JPG
