BackupGGCode/hovercraft/projectWriteup/hover_pics/motor_above.jpg

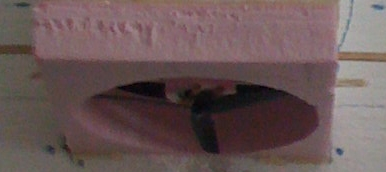
projectWriteup/hover_pics/motor_above.jpg
