BackupGGCode/hovercraft/projectWriteup/hover_pics/motor_front.jpg

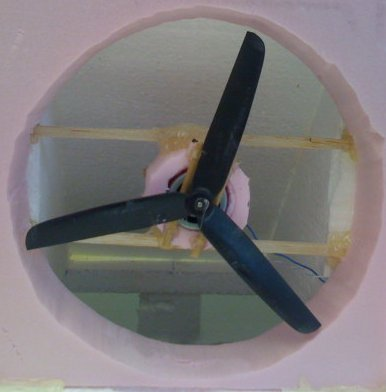
projectWriteup/hover_pics/motor_front.jpg
