BackupGGCode/hovercraft/projectWriteup/ProjectGraphics/DifferentialTurning.graffle/image1.tiff

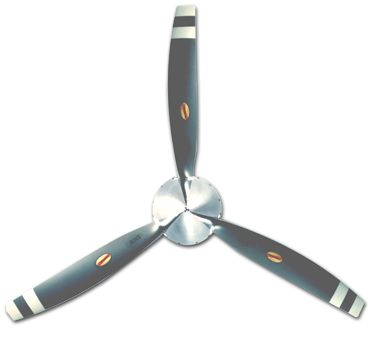
projectWriteup/ProjectGraphics/DifferentialTurning.graffle/image1.tiff
