BackupGGCode/hovercraft/projectWriteup/ProjectGraphics/VortexRing.graffle/image1.tiff

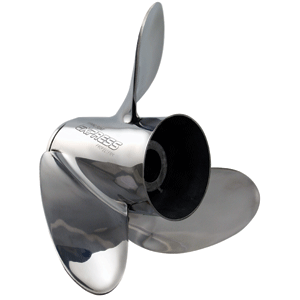
projectWriteup/ProjectGraphics/VortexRing.graffle/image1.tiff
