BackupGGCode/hovercraft/projectWriteup/FINAL_REPORT/textSources/observationsEvaluations.tex

This section describes the outcomes of the various tests and mini-experiments that were performed as the project advances, as well as the pertinent observations made throughout.
