BackupGGCode/hovercraft/XCodeTemplate/Hovercraft Application/main.c

/**
 * Main.
 * 
 * @author: ÇFULLUSERNAMEÈ
 * @copyright: Copyright 2009 ÇFULLUSERNAMEÈ
 * 
 * License: <insert your license reference here>
 */

#include <avr/io.h>

int main(void)
{
    /* insert your hardware initialization here */
    for(;;){
        /* insert your main loop code here */
    }
    return 0;   /* never reached */
}
