BackupGGCode/hovercraft/TestCode/JoyStick-Motors/joyMotors.h

/*
 *  joyMotors.h
 *  joyMotor
 *
 *  Created by Katherine Gunion on 24/01/09.
 *  Copyright 2009 University of Victoria. All rights reserved.
 *
 */

#ifndef _JOYMOTORS_H__
#define  _JOYMOTORS_H__

void updateMotor(void);
void updateVertically(void);


#endif
