BackupGGCode/hovercraft/(commit log)

2009-01-20 Added some test code to demonstrate how to toggle the LEDs using the joystick.
    This code is using interrupts instead of the polling.
2009-01-20 Added interrupt for the up and right.
    TODO: Need to figure out how to differentiate Pin-change interrupts.
2009-01-20 Fixed a small bug in the Makefile, and removed F_CPU in common.h
    [common.h]
2009-01-23 joystick and motor... eat it
2009-01-25 JoyStick to control Motor
2009-01-25 Servo Working Test
2009-01-26 sonar stuff
2009-01-28 sonar Worksish
2009-01-29 working Joystick to radio to motor... Eat it bitches
2009-01-29 working Sonar ish
2009-01-30 servo code
2009-01-30 Changed a case-error in the include. And removed the *.java and *.o files from the project.
    [Motor.c]
2009-02-01 Corrected the case problems.
    [Hover-StationMain.c]
2009-02-02 HoverStation sends back sonar info to base.
    The base station will send out 4 joystick messages, then wait
    indefinietly. The HoverStation has a timeout. When it doesn't receive
    any message from the base, it will send back sonar information.
    [Hover-StationMain.c, mainJoy.c]
2009-03-06 Added a Makefile and comments to the Motor driver code.
    The doxygen configuration file is also added.
2009-03-06 Added untested dual motors driver.
2009-03-07 Completed the dual motor driver.
2009-03-07 Tested the dual-motors driver.
2009-03-13 Added a write up for a pid controller.
    The introduction section is done. The PID Controller primer section
    is still work-in-progress.
2009-03-13 Added graffle files for the PID formala and diagram.
    * Finished the PID prime section.
    * Added graphics.
    * PID and hovercraft section is still work-in-progress.
2009-03-14 Completed the pid controller write up.
2009-03-14 Added pidgraph.py which is a simple PID controller.
2009-03-14 Added a pid code section and changed some parameters.
2009-04-20 Added targets for hovercraft 1 and 2. Fixed comments in basestation
    [basestation.c]
2009-04-21 Added dual motors driver, and implemented hovercraft2.
2009-04-21 Fixed some old code.
    [joyMotors.c, joystick.c, mainJoy.c]
2009-04-21 added sonar.
2009-04-22 Fixed formatting and added the PID forumla.
2009-04-23 Implemented sonar testing code.
2009-04-24 added sonar images.
2009-04-24 Fixed a sonar image.
2009-04-24 Implemented functions for the basestation to receive and print packets.
